eebothobby/g030f6p6_voltm/Schematic_stm32g030f6p6_voltmeter_2025-04-15.pdf

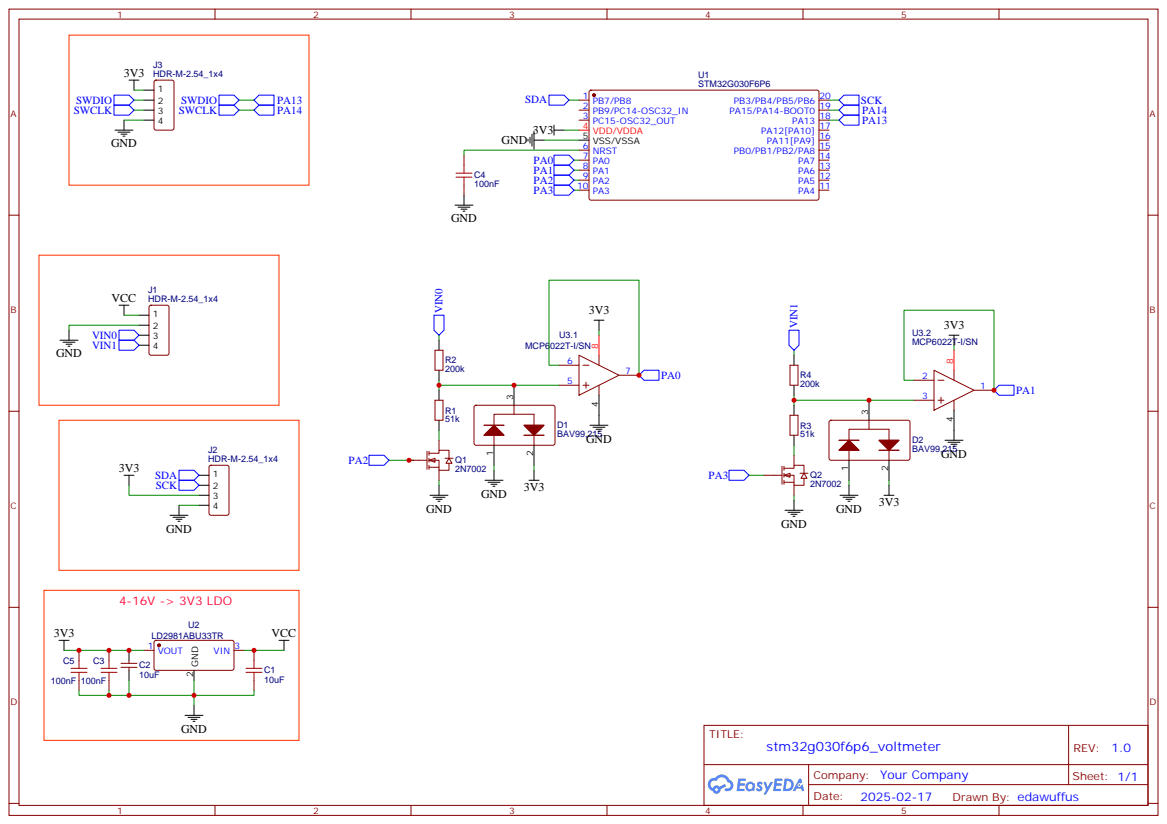
[picture p2: page 1]
