eebothobby/g030f6p6_voltm/Core/Src/main.c

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
/* Includes ------------------------------------------------------------------*/
#include "main.h"

/* USER CODE BEGIN Includes */
#include "ssd1306.h"
#include <stdio.h>

/* USER CODE END Includes */

ADC_HandleTypeDef hadc1;
DMA_HandleTypeDef hdma_adc1;

I2C_HandleTypeDef hi2c1;

/* USER CODE BEGIN PV */

uint16_t adcvals[2];
uint8_t fi2cadr = 0;
// We use millivolts instead of a floating point number for volts
// because including code to support printing floating point numbers
// exceeds the flash size.
uint16_t millivolts[2];
float scale[2]; // Scaling factor based on the status of the PA2, PA3 pins
GPIO_PinState pinstate[2];


/* USER CODE END PV */

void SystemClock_Config(void);
static void MX_GPIO_Init(void);
static void MX_DMA_Init(void);
static void MX_ADC1_Init(void);
static void MX_I2C1_Init(void);
/* USER CODE BEGIN 0 */

// display data on SSD1306 screen
// _BIG_DISP is used for 0.96" 128x64 screen
// otherwise a 0.49" 64x32 screen is used
// Note that we don't use %f for the sprintf because enabling floating point
// formats in the code causes the code size to increase beyond the flash size.
//#define _BIG_DISP
#ifdef _BIG_DISP
void display() {
	char buf[20];
	uint8_t rpix = 0, rht = 12;
	uint16_t volts, mvolts;

	 // row 0
	 ssd1306_SetCursor(0, rpix);
	 sprintf(buf, "%6d %6d", adcvals[0], adcvals[1]);
	 ssd1306_WriteString(buf, Font_7x10, White);

	 rpix += rht; // row 1
	 rht = 20;

	 ssd1306_SetCursor(0, rpix);
	 volts = millivolts[0] / 1000;
	 mvolts = millivolts[0] % 1000;
	 sprintf(buf, "0:%2u.%03u", volts, mvolts);
	 ssd1306_WriteString(buf , Font_11x18, White);

	 rpix += rht; // row 2

	 ssd1306_SetCursor(0, rpix);
	 volts = millivolts[1] / 1000;
	 mvolts = millivolts[1] % 1000;
	 sprintf(buf, "1:%2u.%03u", volts, mvolts);
	 ssd1306_WriteString(buf , Font_11x18, White);

	 ssd1306_UpdateScreen(&hi2c1);
}
#else
void display() {
	char buf[20];
	uint8_t rpix = 32, rht = 12;
	uint16_t volts, mvolts;

	 // row 0
	 ssd1306_SetCursor(32, rpix);
	 volts = millivolts[0] / 1000;
	 mvolts = millivolts[0] % 1000;
	 sprintf(buf, "0:%2u.%03u", volts, mvolts);
	 ssd1306_WriteString(buf , Font_7x10, White);

	 rpix += rht;

	 // row 1
	 ssd1306_SetCursor(32, rpix);
	 volts = millivolts[1] / 1000;
	 mvolts = millivolts[1] % 1000;
	 sprintf(buf, "1:%2u.%03u", volts, mvolts);
	 ssd1306_WriteString(buf , Font_7x10, White);

	 ssd1306_UpdateScreen(&hi2c1);
}
#endif // _BIG_DISP

void setScale(int chan, GPIO_PinState st) {
	pinstate[chan] = st;
	if (chan == 0) {
		HAL_GPIO_WritePin(PA2OUT_GPIO_Port, PA2OUT_Pin, st);
	} else {
		HAL_GPIO_WritePin(PA3OUT_GPIO_Port, PA3OUT_Pin, st);
	}
	if (st == GPIO_PIN_RESET) {
		scale[chan] = 0.050354; // 3300/65536;
	} else {
		scale[chan] = 0.247821; // ((200 + 51)/51) * 3300/65536;
	}
}

/* USER CODE END 0 */

/**
  * @brief  The application entry point.
  * @retval int
  */
int main(void)
{

  /* MCU Configuration--------------------------------------------------------*/

  /* Reset of all peripherals, Initializes the Flash interface and the Systick. */
  HAL_Init();

  /* Configure the system clock */
  SystemClock_Config();

  /* Initialize all configured peripherals */
  MX_GPIO_Init();
  MX_DMA_Init();
  MX_ADC1_Init();
  MX_I2C1_Init();
  /* USER CODE BEGIN 2 */

  for (int i2a = 1; i2a < 127; i2a++) {
  	if (HAL_I2C_IsDeviceReady(&hi2c1, i2a << 1, 1, 10) == HAL_OK) {
  		fi2cadr = i2a;
  	}
  }

  if (ssd1306_Init(&hi2c1) != 0) {
    Error_Handler();
  }

  HAL_Delay(100);

  ssd1306_Fill(Black);
  ssd1306_UpdateScreen(&hi2c1);

  HAL_Delay(100);

  setScale(0, GPIO_PIN_RESET);
  setScale(1, GPIO_PIN_RESET);

  HAL_ADCEx_Calibration_Start(&hadc1);
  HAL_ADC_Start_DMA(&hadc1, (uint32_t *)adcvals, 2);

  /* USER CODE END 2 */

  /* Infinite loop */
  /* USER CODE BEGIN WHILE */
  while (1)
  {
	  for (int i = 0; i < 2; i++) {
		  if ((adcvals[i] > 65000) && (pinstate[i] == GPIO_PIN_RESET)) {
			  setScale(i, GPIO_PIN_SET);
		  } else if ((adcvals[i] < 13000) && (pinstate[i] == GPIO_PIN_SET)) {
			  setScale(i, GPIO_PIN_RESET);
		  }
	  }
	  HAL_Delay(100);
	  for (int i = 0; i < 2; i++) {
		  millivolts[i] = adcvals[i] * scale[i];
	  }
	  display();
    /* USER CODE END WHILE */

    /* USER CODE BEGIN 3 */
  }
  /* USER CODE END 3 */
}

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
