eebothobby/g030f6p6_voltm/g030f6p6_voltm.ioc

Mcu.UserName=STM32G030F6Px
PA0.Signal=ADC1_IN0
PA1.Signal=ADC1_IN1
PA13.Signal=SYS_SWDIO
PA14-BOOT0.Signal=SYS_SWCLK
PA2.GPIO_Label=PA2OUT
PA2.Signal=GPIO_Output
PA3.GPIO_Label=PA3OUT
PA3.Signal=GPIO_Output
PB6.Signal=I2C1_SCL
PB7.Signal=I2C1_SDA
