eebothobby/g030f6p6_voltm/Core/Inc/main.h

#define PA2OUT_Pin GPIO_PIN_2
#define PA2OUT_GPIO_Port GPIOA
#define PA3OUT_Pin GPIO_PIN_3
#define PA3OUT_GPIO_Port GPIOA
