eebothobby/g030f6p6_voltm/(commit log)

2025-04-22 Update main.c
    Print voltages in Volts, not mV by explicitly printing integer part and fractional part.
    Keep track of each MOSFET gate drive pin state and only change if necessary,
2025-05-31 Add schematic pdf and photo
